ravin360/Automatic-Brightness-control-system/README.md

# Automatic-Brightness-control-system
Designing a brightness control system using analog components
