ravin360/Automatic-Brightness-control-system/(list of files, drawings)

Other design files:
Automatic Lighting system.pdsprj
